xzhang03/bPACstim/PWMpulsebox v3 PCB/Schematic_Optostim receiver v3.1_2023-09-05.png

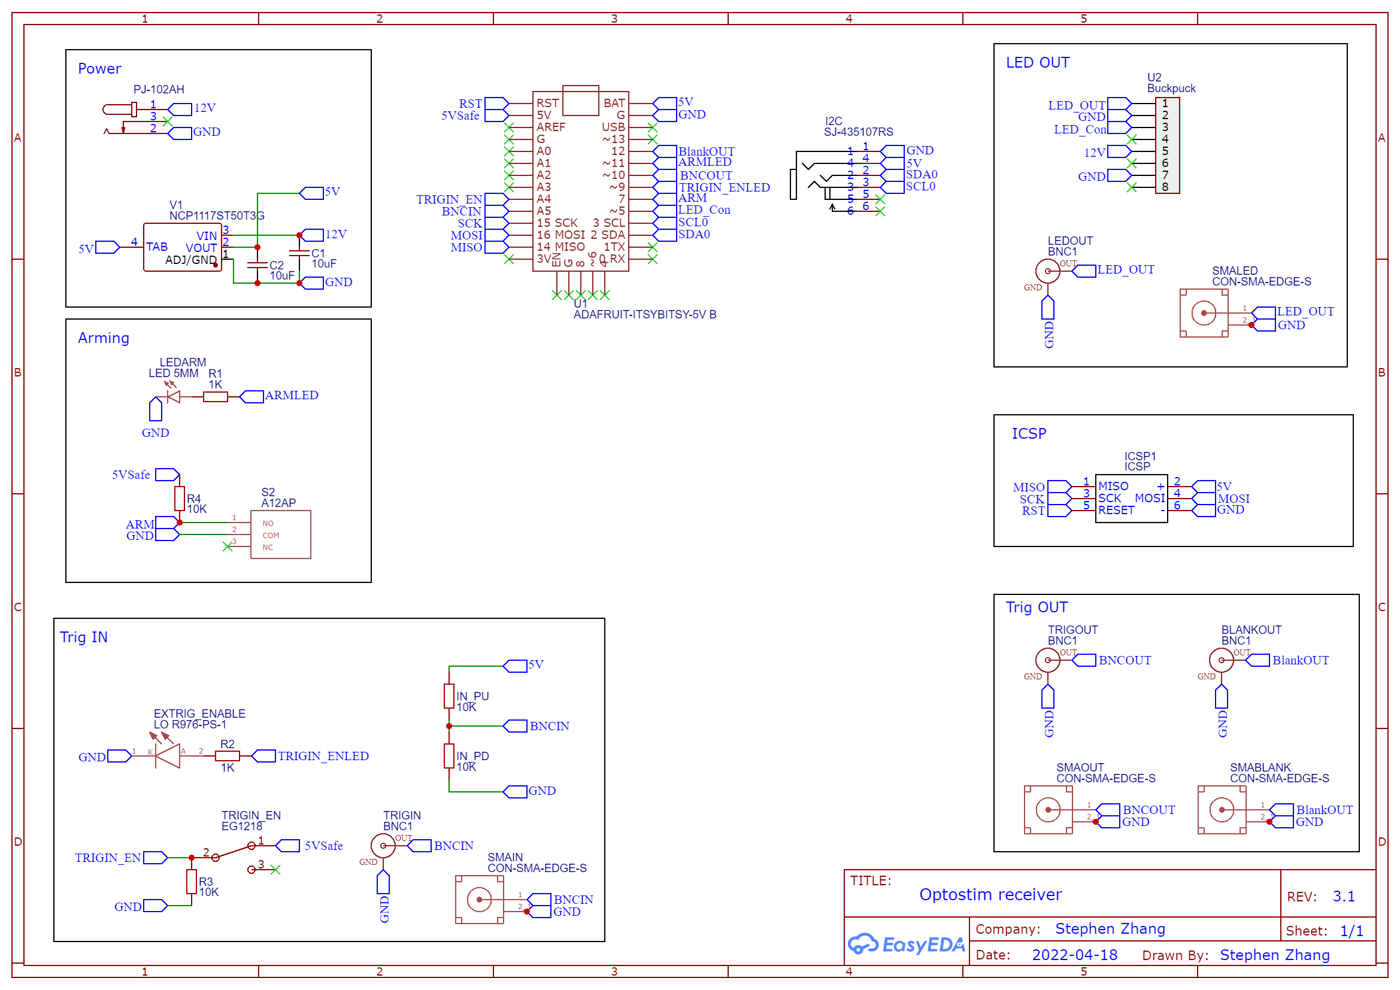
PWMpulsebox v3 PCB/Schematic_Optostim receiver v3.1_2023-09-05.png
