xzhang03/bPACstim/PWMpulsebox v2 PCB/Optostim Receiver BOM.xlsx

Country of Origin may be different at time of shipment.
The HTSUS and ECCN information shown is for informational purposes only and is not a representation or warranty as to the accuracy or reliability of these classifications. All information is provided "as is" and is subject to change without notice. Any use made of the information provided is without recourse to Digi-Key and at the user's risk.
Index | Manufacturer Part Number | Manufacturer Name | Description | Availability | Stock Status | Attrition % | Requested Quantity 1 | Pack Quantity 1 | Pack Type 1 | Digi-Key Part Number 1 | Unit Price 1 | Extended Price 1 | Minimum Order Quantity 1 | Customer Reference | Requested Part Number | Lead Weeks | Datasheet | Reference Designator | US Import Tariff | Note | Part Status | RoHS Status | ECCN | HTSUS | Country of Origin | Environmental Information | Original Part numbers | Image
1 | SJ-435107RS | CUI Devices | CONN JACK 4COND 3.5MM R/A | 15,403 | In Stock |  | 1 | 1 | Tray | CP-435107RS-ND | 1.78000 | $1.78 | 1 |  | CP-435107RS-ND | 24 | https://www.cuidevices.com/product/resource/sj-435107.pdf |  | N/A |  | Active | ROHS3 Compliant | EAR99 | 8536.69.4040 | China | https://www.cuidevices.com/product/resource/material-compliance/sj-435107-series | CP-435107RS-ND | //media.digikey.com/Photos/CUI%20Photos/MFG_SJ-435107.jpg
2 | 3677 | Adafruit Industries LLC | ITSY BITSY 32U4 5V 16MHZ EVAL BD | 154 | In Stock |  | 1 | 1 | Bulk | 1528-2501-ND | 9.95000 | $9.95 | 1 |  | 1528-2501-ND | 2 | https://cdn-learn.adafruit.com/downloads/pdf/introducting-itsy-bitsy-32u4.pdf |  | N/A |  | Active | ROHS3 Compliant | EAR99 | 8471.50.0150 | United States |  | 1528-2501-ND | //media.digikey.com/Photos/Adafruit%20Industries%20LLC/MFG_3677.jpg
3 | DS01C-254-L-03BE | CUI Devices | DIP SWITCH, SPST, 2.54 PITCH, RA | 1,009 | In Stock |  | 1 | 1 | Tube | 2223-DS01C-254-L-03BE-ND | 0.57000 | $0.57 | 1 |  | DS01C-254-L-03BE | 10 | https://www.cuidevices.com/product/resource/ds01-254.pdf |  | May apply on shipments to the U.S. |  | Active | ROHS3 Compliant | EAR99 | 8536.50.9065 | China | https://www.cuidevices.com/product/resource/material-compliance/ds01-254-series | DS01C-254-L-03BE | //media.digikey.com/Photos/CUI%20Photos/MFG_DS01-254-03.jpg
4 | 1-2834015-6 | TE Connectivity AMP Connectors | TERM BLK 6POS TOP ENT 2.54MM PCB | 1,683 | In Stock |  | 1 | 1 | Bulk | A123828-ND | 2.41000 | $2.41 | 1 |  | 1-2834015-6 | 39 | https://www.te.com/commerce/DocumentDelivery/DDEController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 |  | May apply on shipments to the U.S. |  | Active | RoHS Compliant | EAR99 | 8536.69.4040 | China |  | 1-2834015-6 | //media.digikey.com/photos/TE%20Connectivity/1-2834015-6.JPG
5 | CR0805-FX-4701ELF | Bourns Inc. | RES SMD 4.7K OHM 1% 1/8W 0805 | 285,237 | In Stock |  | 3 | 3 | Cut Tape (CT) | CR0805-FX-4701ELFCT-ND | 0.10000 | $0.30 | 1 |  | CR0805-FX-4701ELF | 15 | https://www.bourns.com/docs/product-datasheets/cr.pdf?sfvrsn=574d41f6_14 |  | N/A |  | Active | ROHS3 Compliant | EAR99 | 8533.21.0030 | Taiwan | https://www.bourns.com/docs/Product-MDS/cr0805_mds.pdf|https://www.bourns.com/docs/rohs-cofc/crx_coc.pdf?sfvrsn=db3a74f6_10|https://www.bourns.com/docs/rohs-content/bourns-reach-letter.pdf | CR0805-FX-4701ELF | //media.digikey.com/Renders/Bourns%20Renders/CR0805-(2012-Metric).jpg
6 | A12AP | NKK Switches | SWITCH TOGGLE SPDT 0.4VA 28V | 6,450 | In Stock |  | 1 | 1 | Tray | 360-3252-ND | 4.97000 | $4.97 | 1 |  | A12AP | 22 | https://www.nkkswitches.com/pdf/Atoggles.pdf |  | N/A |  | Active | ROHS3 Compliant | EAR99 | 8536.50.9065 | Japan | https://www.nkkswitches.com/pdf/Switches-and-Pushbuttons-RoHS-Certificate-of-Compliance.pdf|https://www.nkkswitches.com/pdf/PFOS-and-PFOA-Free-Certificate.pdf|https://www.nkkswitches.com/pdf/Ozone-Depleting-Chemical-Free-Manufacturing-Certificate-.pdf | A12AP | //media.digikey.com/Photos/NKK%20Switches%20Photos/A12AP.jpg
7 | NCP1117ST50T3G | onsemi | IC REG LINEAR 5V 1A SOT223 | 242 | In Stock |  | 1 | 1 | Cut Tape (CT) | NCP1117ST50T3GOSCT-ND | 0.72000 | $0.72 | 1 |  | NCP1117ST50T3G | 58 | https://www.onsemi.com/pdf/datasheet/ncp1117-d.pdf |  | N/A |  | Active | ROHS3 Compliant | EAR99 | 8542.39.0001 | Malaysia | https://www.onsemi.com/PowerSolutions/MaterialComposition.do?export=pdf&opnId=NCP1117ST50T3G|https://www.onsemi.com/site/pdf/RoHS-statement.pdf|https://www.onsemi.com/site/pdf/REACH-compliance-statement.pdf | NCP1117ST50T3G | //media.digikey.com/Renders/Diodes%20Renders/SOT223-3L.jpg
8 | CL21A106KPFNNNE | Samsung Electro-Mechanics | CAP CER 10UF 10V X5R 0805 | 2,792,077 | In Stock |  | 2 | 2 | Cut Tape (CT) | 1276-1052-1-ND | 0.11000 | $0.22 | 1 |  | CL21A106KPFNNNE | 22 | https://www.samsungsem.com/kr/support/product-search/mlcc/CL21A106KPFNNNE.jsp |  | N/A |  | Active | ROHS3 Compliant | EAR99 | 8532.24.0020 | China | https://www.samsungsem.com/global/support/certificate/product-stewardship.do|https://www.samsungsem.com/files/fileDown.do?key=ed1dfdfa-645e-4252-b707-17f9b1502dd1 | CL21A106KPFNNNE | //media.digikey.com/Renders/Samsung%20Electro-Mechanics%20America/Ceramic-Capacitor-CL-Series.jpg
9 | PJ-102A | CUI Devices | CONN PWR JACK 2X5.5MM SOLDER | 92,528 | In Stock |  | 1 | 1 | Tray | CP-102A-ND | 0.77000 | $0.77 | 1 |  | PJ-102A | 24 | https://www.cuidevices.com/product/resource/pj-102a.pdf |  | N/A |  | Active | ROHS3 Compliant | EAR99 | 8536.69.4040 | China | https://www.cuidevices.com/product/resource/material-compliance/pj-102a | PJ-102A | //media.digikey.com/Photos/CUI%20Photos/PJ-102A.jpg
10 | CR0805-FX-1001ELF | Bourns Inc. | RES SMD 1K OHM 1% 1/8W 0805 | 1,558,028 | In Stock |  | 1 | 1 | Cut Tape (CT) | CR0805-FX-1001ELFCT-ND | 0.10000 | $0.10 | 1 |  | CR0805-FX-1001ELF | 15 | https://www.bourns.com/docs/product-datasheets/cr.pdf?sfvrsn=574d41f6_14 |  | N/A |  | Active | ROHS3 Compliant | EAR99 | 8533.21.0030 | Taiwan | https://www.bourns.com/docs/Product-MDS/cr0805_mds.pdf|https://www.bourns.com/docs/rohs-cofc/crx_coc.pdf?sfvrsn=db3a74f6_10|https://www.bourns.com/docs/rohs-content/bourns-reach-letter.pdf | CR0805-FX-1001ELF | //media.digikey.com/Renders/Bourns%20Renders/CR0805-(2012-Metric).jpg
11 | 0731375003 | Molex | CONN BNC RCPT R/A 50 OHM PCB | 29,365 | In Stock |  | 1 | 1 | Tray | WM5514-ND | 2.65000 | $2.65 | 1 |  | 0731375003 | 12 | https://www.molex.com/pdm_docs/sd/731375003_sd.pdf |  | N/A |  | Active | ROHS3 Compliant | EAR99 | 8536.69.4010 | Taiwan |  | 0731375003 | //media.digikey.com/Photos/Molex/0731375003.jpg
12 | XCMDK12D | SunLED | 5MM LC RED LED | 14,206 | In Stock |  | 1 | 1 | Bulk | 1497-XCMDK12D-ND | 0.35000 | $0.35 | 1 |  | 1497-XCMDK12D-ND | 8 | https://www.sunledusa.com/products/spec/XCMDK12D.pdf |  | May apply on shipments to the U.S. |  | Active | ROHS3 Compliant | EAR99 | 8541.41.0000 | China |  | 1497-XCMDK12D-ND | //media.digikey.com/Photos/SunLED/MFG_XCMDK12D.jpg
13 | 3021-D-E-350 | LEDdynamics Inc. | LED SUPP CC BUCK 32V 350MA 7SIP | 0 | Normally Stocking |  | 1 | 1 | Bulk | 788-1113-ND | 10.99000 | $10.99 | 1 |  | 788-1113-ND | 5 | https://leddynamics.com/buckpuck-302xd |  | N/A |  | Active | RoHS Compliant | EAR99 | 8504.40.9580 | United States |  | 788-1113-ND | //media.digikey.com/Photos/LEDdynamics/BuckPuck%203021.jpg
