xzhang03/bPACstim/(list of files, drawings)

Other design files:
old/PWMpulsebox v2 PCB/EasyEDA_PCB_Optostim receiver v1.1_2022-06-06.json
PWMpulsebox v2 PCB/EasyEDA_PCB_Optostim receiver v1.1_2022-06-06.json
PWMpulsebox v3 PCB/PCB_PCB_Optostim receiver v3.1_2023-09-05.json
PWMpulsebox v3 PCB/SCH_Optostim receiver v3.1_2023-09-05.json
