xzhang03/bPACstim/PWMpulsebox v3/PWMtrainbox_receiver/i2a.ino

/*
 * I2C menu
 * 1.  Start
 * 2.  Stop
 * 3.  Change single value
 * 4.  Ping single value in numrem
 * 5.  Ping single value in num
 * 6.  Ping entire array
 * 7.  Ping arm/input_en
 * 8.  Ping train on status
 * 9.  Ping 42
 * 10. Change always arm
 * 13. Change mods
 * 14. Check modes (0 - auto, 1 - semiauto, 2 - passive)
 */
