xzhang03/bPACstim/(commit log)

2021-09-03 v2 is more precise in time
    less overhead on the arduino
2022-04-19 Update Schematic_Optostim receiver_2022-04-19.png
2022-06-06 updated version with BNC output
    [EasyEDA_PCB_Optostim receiver v1.1_2022-06-06.json, EasyEDA_PCB_Optostim receiver_2022-04-19.json]
2022-09-16 Create Optostim Receiver BOM.xlsx
    [Optostim Receiver BOM.xlsx]
2022-09-16 Update Optostim Receiver BOM.xlsx
    [Optostim Receiver BOM.xlsx]
2023-07-27 New PWM Trainbox
    [EasyEDA_PCB_Optostim receiver v1.1_2022-06-06.json, Optostim Receiver BOM.xlsx, PCB_PCB_Optostim receiver v3.0_2023-07-27.json, SCH_Optostim receiver v3.0_2023-07-25.json]
2023-09-05 updated to 3.1
    [PCB_PCB_Optostim receiver v3.0_2023-07-27.json, PCB_PCB_Optostim receiver v3.1_2023-09-05.json, SCH_Optostim receiver v3.0_2023-07-25.json, SCH_Optostim receiver v3.1_2023-09-05.json]
